Zdylas/RoboCup/README.md

# RoboCup
Small repository demonstrating the code for ENMT301 Robocup competition at University of Canterbury
